K-Thanushan/Simple-Voice-Recorder/README.md

# Simple-Voice-Recorder

The task given to us was to build a simple voice recorder that records an audio, saves the recorded audio file and plays an audio file that is selected by the user. The PCB and the enclosure was designed for the voice recorder.
