K-Thanushan/Simple-Voice-Recorder/(list of files, drawings)

Other design files:
Resources made by us/Recording with TMRpcm/Simulation with Audio Source.pdsprj
Resources made by us/Recording with TMRpcm/Simulation with Mic.pdsprj
Resources made by us/Recording with TXT/Simulation with Audio Source and DAC.pdsprj
Resources made by us/Simulation with Audio Source.pdsprj
Resources made by us/Simulation with Mic.pdsprj
Simulation/VoiceRecorder - Arduino.pdsprj
Simulation/VoiceRecorder - ATMEGA328p.pdsprj
VoiceRecorderPCB/VoiceRecorder1.PcbDoc
VoiceRecorderPCB/VoiceRecorderPCB.PrjPcb
VoiceRecorderPCB/VoiceRecorderSchematic.SchDoc
