K-Thanushan/Simple-Voice-Recorder/Resources made by us/Recording with TXT/VoiceRecorder.h

#pragma once

class VoiceRecorder
{
    public:
    
        VoiceRecorder(int UpButton, int DownButton, int EnterButton, int BackButton, int Position, int FileIndex);
        void Start();
        void Up();
        void Down();
        void Enter();
        void Back();
        void MenuPosition1(int a, String Displaytext1, String Displaytext2);
        void MenuPosition2(int a, String Displaytext3, String Displaytext4);
        void startRecording();
        void stopRecording();
        void startPlayback(String fileName);
        void deleteRecording(String fileName);
        void freq_shift(String fileName,int shiftFrq);
        void reset();
        int _enter;
        int _back;
        int _down;
        int _up;
        int _Position;
        int _FileIndex; 
    
    private:
        static void changeState();
        String threedig(int decimal);

};
