K-Thanushan/Simple-Voice-Recorder/(commit log)

2021-05-01 Initial Code for LCD Display
    [LCD_Menu.pdsprj]
2021-05-02 Generalized Position functions to a single MenuPosition position
    [LCD_Menu.pdsprj]
2021-05-03 Added scrolling effect to LCD Menu
    [LCD_Menu.pdsprj]
2021-05-20 Made modifications in the Menu Position function
    [LCD_Menu.pdsprj]
2021-05-23 Restructured the Display Menu code
    [LCD_Menu.pdsprj]
2021-05-23 Made corrections for the back button
    [LCD_Menu.pdsprj]
2021-05-23 Corrected Back button and volume increasing errors
    [Simulation.pdsprj]
2021-05-28 Added mid evaluation final code to main branch
    [LCD_Menu.pdsprj, Simulation with Audio Source.pdsprj, Simulation with Mic.pdsprj, Simulation.pdsprj]
2021-06-06 Updated code in main branch
    [Simulation with Audio Source and DAC.pdsprj, Simulation with Audio Source.pdsprj, Simulation with Mic.pdsprj]
2021-08-16 Final executable code shown for evaluation
    [Simulation with Audio Source and DAC.pdsprj, Simulation with Audio Source.pdsprj, Simulation with Mic.pdsprj, VoiceRecorder - ATMEGA328p.pdsprj, VoiceRecorder - Arduino.pdsprj]
2021-08-16 Uploaded PCB files
    [VoiceRecorder1.PcbDoc, VoiceRecorderPCB.PrjPcb, VoiceRecorderSchematic.SchDoc]
2021-08-18 Uploaded Final report unzipped folder
    [VoiceRecorder1.PcbDoc]
